Joshuar9202/Swerve-Drive-Arduino/Wiring Diagrams/swerve drive wiring.png

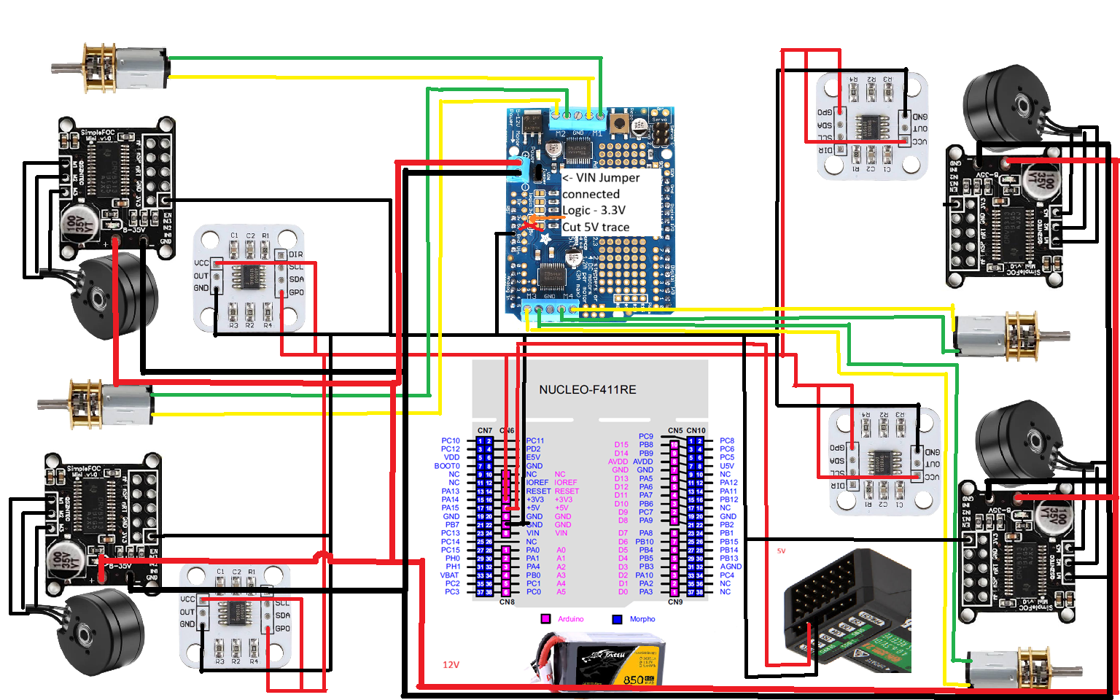
Wiring Diagrams/swerve drive wiring.png
