Joshuar9202/Swerve-Drive-Arduino/CAD and BOM/Swerve Drive BOM.xlsx

Item Name | Qty | Price (total) (USD) | Item link | Notes
SimpleFOC Driver | 4 | $7.99 | https://www.amazon.com/dp/B0CMD2316W?ref=ppx_yo2ov_dt_b_fed_asin_title | SimpleFOC v1.0 driver for the driving the brushless gimbal motors.
Brushless Gimbal Motor | 4 | $13.79 | https://www.amazon.com/sspa/click
Adafruit Motor Shield v2 | 1 | $19.95 | https://www.adafruit.com/product/1438
N20 Gearmotor | 2 | $9.99 | https://www.amazon.com/dp/B0CHRX8Q14?ref=ppx_yo2ov_dt_b_fed_asin_title | 2 pcs in 1
AS5600 Encoders | 1 | $8.99 | https://www.amazon.com/dp/B09SD7RHXS?ref=ppx_yo2ov_dt_b_fed_asin_title | 4 pcs in 1
STM32 Nucelo 64 F411RE | 1 | $28.88 | https://www.amazon.com/dp/B07JYF8RRB?ref=ppx_yo2ov_dt_b_fed_asin_title
XT30 Connectors | 1 | $8.99 | https://www.amazon.com/dp/B09LYHHS9J?ref_=ppx_hzsearch_conn_dt_b_fed_asin_title_1 | Contains 5x pairs
12 volt lipo | 1 | $15.71 | https://www.amazon.com/dp/B074MG6YGS/ref=twister_B0CCDVYRNT?_encoding=UTF8&th=1
MPU6050 | 1 | $6.99 | https://www.amazon.com/dp/B01DK83ZYQ?ref_=ppx_hzsearch_conn_dt_b_fed_asin_title_7
5 port wagos | 1 | $10.47 | https://www.homedepot.com/p/WAGO-221-415K006-000-5-Wire-Lever-Nuts-Conductor-Compact-Splicing-Connectors-12-24-AWG-10-Pack-221-415K006-000/334555610 | 10 pack, only 2 are needed
M3 Screws | 1 | $7.98 | https://www.amazon.com/dp/B0DDXYX6KN?ref=ppx_yo2ov_dt_b_fed_asin_title | assorted, obviously not all are used
M2 Screws | 1 | $6.99 | https://www.amazon.com/dp/B0DDY2L533?ref=ppx_yo2ov_dt_b_fed_asin_title | assorted, obviously not all are used
Flysky Controller and Reciever | 1 | $56.90 | https://www.amazon.com/dp/B0B3R1K9KC?ref_=ppx_hzsearch_conn_dt_b_fed_asin_title_2
mini breadboard | 1 | $1.50 | https://www.amazon.com/dp/B07TBMNTPQ?ref_=ppx_hzsearch_conn_dt_b_fed_asin_title_5
jumper wires | 1 | $6.98 | amazon.com/Elegoo-EL-CP-004-Multicolored-Breadboard-arduino/dp/B01EV70C78/ref=sr_1_1_sspa?crid=4REY28GS1PNB&dib=eyJ2IjoiMSJ9.QGbaFF62mgZ1Tf0J7CajkKK_QnohU3vh2tgdUjfAZdbU3v2uZan5B4FNNpdxZ_1oxubdt_Oxiymd2TTly5drie147GLYtS-m-0FtWGzBVSY82BxA0FTnwZYdFxf6KCX89OF2LiurxqcDtFwg-ay6Nu4UVPmcwph3xOWo7KEbU-EbI4rjs5jGc-GA9vQ6xhn91WxKfpmP4igXUZ-l_jwK3qw0kuNmCWRiMj4HEGCc_bNLKVtyBpBDkyofYcvez5Zz9oqAPxm8MA3hQVeiYUFtEZbU3lNpPMllVFX0i5G0_fU.CDWYUhLF3CP9yzOWB9F4uKJTVUKlf8sJ97FZCG-lgSs&dib_tag=se&keywords=jumper+wires&qid=1783044086&s=industrial&sprefix=jumper+wires%2Cindustrial%2C256&sr=1-1-spons&sp_csd=d2lkZ2V0TmFtZT1zcF9hdGY&psc=1
Total Price (USD): | $287.43
