Joshuar9202/Swerve-Drive-Arduino/Wiring Diagrams/drive motor wiring.png

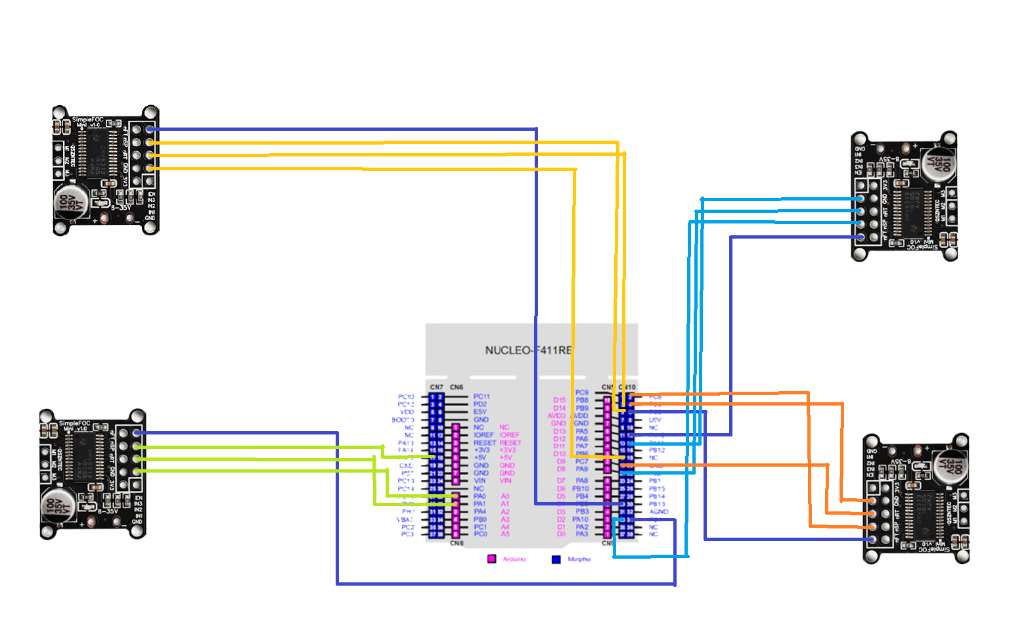
Wiring Diagrams/drive motor wiring.png
