Joshuar9202/Swerve-Drive-Arduino/(commit log)

2026-07-03 Enhance README with build and wiring instructions
    Expanded the README with detailed sections on build, printing, assembly, wiring, and code upload instructions.
2026-07-04 Enhance README with motor module pin details and lib deps
    Updated the README to include detailed pin assignments for each motor module and added a note about pin configuration requirements.
2026-07-04 Update README with Bill of Materials and CAD links
    Added links for Bill of Materials and CAD documentation.
2026-07-05 Update README with demo video and assembly details
    Added a demo video link and additional assembly instructions for securing the encoder column.
2026-07-05 Rename drive motor wiring.png to Wiring Diagrams/drive motor wiring.png
2026-07-05 Rename swerve drive wiring.png to Wiring Diagrams/swerve drive wiring.png
2026-07-05 Rename Swerve Drive BOM.xlsx to CAD and BOM/Swerve Drive BOM.xlsx
    [Swerve Drive BOM.xlsx]
2026-07-05 Add CAD Link to CAD and BOM
2026-07-06 Add credits and AI usage declaration to README
    Added credits section for Swerve Kinematics and AI usage declaration.
